achaval-tomas/SistemasDeTiempoReal/Core/Src/main.c

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
/* Includes ------------------------------------------------------------------*/
#include "main.h"
#include "i2c.h"
#include "icache.h"
#include "tim.h"
#include "gpio.h"

/* USER CODE BEGIN Includes */
#include "main_app.h"


void SystemClock_Config(void);
static void MPU_Config(void);
void MX_FREERTOS_Init(void);

/**
  * @brief  The application entry point.
  * @retval int
  */
int main(void)
{
  // Inicializar sistema
  MPU_Config();
  HAL_Init();
  SystemClock_Config();
  MX_ICACHE_Init();

  // Inicializar periféricos
  MX_GPIO_Init();
  MX_I2C1_Init();
  MX_I2C2_Init();
  MX_TIM2_Init();
  MX_TIM3_Init();

  // Lanzar el variómetro
  start_variometer();

  // Nunca se debería alcanzar este punto
  while (1){}
}

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
 /* MPU Configuration */

void MPU_Config(void)
{
  MPU_Region_InitTypeDef MPU_InitStruct = {0};
  MPU_Attributes_InitTypeDef MPU_AttributesInit = {0};

  /* Disables the MPU */
  HAL_MPU_Disable();

  /** Initializes and configures the Region 0 and the memory to be protected
  */
  MPU_InitStruct.Enable = MPU_REGION_ENABLE;
  MPU_InitStruct.Number = MPU_REGION_NUMBER0;
  MPU_InitStruct.BaseAddress = 0x08FFF000;
  MPU_InitStruct.LimitAddress = 0x08FFFFFF;
  MPU_InitStruct.AttributesIndex = MPU_ATTRIBUTES_NUMBER0;
  MPU_InitStruct.AccessPermission = MPU_REGION_ALL_RO;
  MPU_InitStruct.DisableExec = MPU_INSTRUCTION_ACCESS_DISABLE;
  MPU_InitStruct.IsShareable = MPU_ACCESS_NOT_SHAREABLE;

  HAL_MPU_ConfigRegion(&MPU_InitStruct);

  /** Initializes and configures the Attribute 0 and the memory to be protected
  */
  MPU_AttributesInit.Number = MPU_ATTRIBUTES_NUMBER0;
  MPU_AttributesInit.Attributes = INNER_OUTER(MPU_NOT_CACHEABLE);

  HAL_MPU_ConfigMemoryAttributes(&MPU_AttributesInit);
  /* Enables the MPU */
  HAL_MPU_Enable(MPU_PRIVILEGED_DEFAULT);

}

/**
  * @brief  Period elapsed callback in non blocking mode
  * @note   This function is called  when TIM6 interrupt took place, inside
  * HAL_TIM_IRQHandler(). It makes a direct call to HAL_IncTick() to increment
  * a global variable "uwTick" used as application time base.
  * @param  htim : TIM handle
  * @retval None
  */
void HAL_TIM_PeriodElapsedCallback(TIM_HandleTypeDef *htim)
{
  if (htim->Instance == TIM6)
  {
    HAL_IncTick();
  }
}

/**
  * @brief  This function is executed in case of error occurrence.
  * @retval None
  */
#include "lcd.h"
void Error_Handler(void)
{
  // Por ahora, los errores de hardware se muestran en la LCD
  // y luego se reincializa el sistema completo.
  lcd_init_emergency();
  lcd_printf_at(0, 0, "ERROR DE HARDWARE   ");
  lcd_printf_at(1, 0, "Sistema detenido    ");
  lcd_printf_at(2, 0, "Reintente encender  ");
  lcd_printf_at(3, 0, "el sistema en 5s... ");

  HAL_Delay(5000);

  // Reiniciar el sistema
  NVIC_SystemReset();
}

#ifdef USE_FULL_ASSERT
/**
  * @brief  Reports the name of the source file and the source line number
  *         where the assert_param error has occurred.
  * @param  file: pointer to the source file name
  * @param  line: assert_param error line source number
  * @retval None
  */
void assert_failed(uint8_t *file, uint32_t line)
{
  /* USER CODE BEGIN 6 */
  /* User can add his own implementation to report the file name and line number,
     ex: printf("Wrong parameters value: file %s on line %d\r\n", file, line) */
  /* USER CODE END 6 */
}
#endif /* USE_FULL_ASSERT */
