achaval-tomas/SistemasDeTiempoReal/Proyecto_FreeRtos.ioc

Mcu.UserName=STM32H533RETx
PA0.Signal=S_TIM2_CH1
PA13(JTMS/SWDIO).GPIO_Label=SWDIO
PA13(JTMS/SWDIO).Signal=DEBUG_JTMS-SWDIO
PA14(JTCK/SWCLK).GPIO_Label=SWCLK
PA14(JTCK/SWCLK).Signal=DEBUG_JTCK-SWCLK
PA15(JTDI).GPIO_Label=JTDI
PA15(JTDI).Signal=DEBUG_JTDI
PA2.Signal=USART2_TX
PA3.Signal=USART2_RX
PA6.Signal=S_TIM3_CH1
PA7.Signal=S_TIM3_CH2
PB10.Signal=I2C2_SCL
PB12.Signal=I2C2_SDA
PB3(JTDO/TRACESWO).GPIO_Label=SWO
PB3(JTDO/TRACESWO).Signal=DEBUG_JTDO-SWO
PB6.Signal=I2C1_SCL
PB7.Signal=I2C1_SDA
PC9.Signal=GPXTI9
