achaval-tomas/SistemasDeTiempoReal/Variometer/Src/task_sensor.c

#include "my_tasks.h"
#include "bmp280.h"
#include "portmacrocommon.h"
#include "projdefs.h"

// Estado actual y datos del filtro de Kalman
typedef struct {
    float pressure;     // presión en Pa
    float dp_dt;        // derivada de la presión en Pa/s
    float P[2][2];      // Matriz de covarianza de error
    float Q[2];         // Ruido de proceso (ajustable)
    float R;            // Ruido de medición (ajustable)
} sensorState_td;

sensorState_td sState = {
    .pressure = 0.0f, // DEBE SER INICIALIZADO CON UN VALOR DE PRESIÓN
    .dp_dt = 0.0f,
    .P =
    {
    {1.0f, 0.0f},
    {0.0f, 1.0f}
    },
    .Q =
    {
        0.001f,  // "Varianza" de la presión por paso
        0.01f    // "Varianza" de la derivada de la presión por paso
    },
    .R = 1.69f  // Sensor noise variance (RMS^2 según bosch)
};

static const float sensitivity_map[10] = {
    0.001f, 0.002f, 0.005f, 0.012f, 0.025f, 
    0.050f, 0.100f, 0.200f, 0.300f, 0.400f
};

float get_real_sensitivity(uint8_t user_level) {
    if (user_level < 1) user_level = 1;
    if (user_level > 10) user_level = 10;
    
    return sensitivity_map[user_level - 1];
}

// Inicializa los parámetros del filtro con un promedio de 30 lecturas del sensor.
void initialize_kalman(){
    bmp280_td bmp280 = {0};
    float pressSum = 0.0f;

    for (uint8_t i = 0; i < 30; ++i){
        bmp280_read_data(&bmp280);
        pressSum += bmp280.pressure_Pa;
        vTaskDelay(pdMS_TO_TICKS(100));
    }
    
    sState.pressure = pressSum / 30;
    sState.dp_dt = 0.0f;
    
    // Aplicar la sensibilidad definida por el usuario
    sState.Q[1] = get_real_sensitivity(varioConfig.sensitivity);
}

void apply_kalman_filter(float new_pressure) {
    static const float dt_s = (float)SENSOR_DT_MS / 1000.0f;

    // Predicción de la próxima presión
    sState.pressure = sState.pressure + (sState.dp_dt * dt_s);
    // Asumimos que dp_dt es constante durante dt_s

    // P = F*P*F' + Q
    float P00 = sState.P[0][0] + dt_s * (sState.P[1][0] + sState.P[0][1] + dt_s * sState.P[1][1]) + sState.Q[0];
    float P01 = sState.P[0][1] + dt_s * sState.P[1][1];
    float P10 = sState.P[1][0] + dt_s * sState.P[1][1];
    float P11 = sState.P[1][1] + sState.Q[1];

    // "Ganancia de Kalman"
    float S = P00 + sState.R;
    float K0 = P00 / S;
    float K1 = P10 / S;

    // Corrección del estado (x = x + K*y)
    float y = new_pressure - sState.pressure;
    sState.pressure += K0 * y;
    sState.dp_dt += K1 * y;

    // Corrección de covarianza (P = (I - KH)*P)
    sState.P[0][0] = (1.0f - K0) * P00;
    sState.P[0][1] = (1.0f - K0) * P01;
    sState.P[1][0] = P10 - (K1 * P00);
    sState.P[1][1] = P11 - (K1 * P01);
}

// Obtiene y filtra datos del sensor BMP280 para enviarlos a las tareas de buzzer y display
void BMP280Task(void *pvParameters) {
    float climb_rate = 0.0f;
    bmp280_td bmp280 = {0};
    buzzerQueueData_td buzzMsg = {0};
    displayQueueData_td dispMsg = {0};
    TickType_t lastTick;
    const TickType_t sensorDelayTicks = pdMS_TO_TICKS(SENSOR_DT_MS);
    
    // Inicializar el sensor con los parámetros deseados
    bmp280_init((bmp280_settings_td){
      .config = BMP_STANDBY_0_5ms | BMP_FILTER_OFF,
      .ctrl_meas = BMP_T_OSRS_1 | BMP_P_OSRS_16 | BMP_MODE_NORMAL
    });

    // Poner el sensor en modo sleep para ahorrar energía hasta que sea necesario
    bmp280_sleep();

sensor_off:
    // Esperar notificación de inicio de vuelo para despertar el sensor
    ulTaskNotifyTake(pdFALSE, portMAX_DELAY);
    bmp280_resume();
    
    // Notificar a la tarea del buzzer para que inicie
    buzzMsg.type = BUZZ_STARTUP;
    xQueueOverwrite(buzzerQueue, &buzzMsg);
    
    // Notificar al display que se inició un vuelo
    dispMsg.type = DISPLAY_START_FLIGHT;
    xQueueOverwrite(displayQueue, &dispMsg);

    // Obtener un primer valor de presión estabilizado
    // e inicializar los parámetros del filtro de Kalman
    initialize_kalman();

    lastTick = xTaskGetTickCount();
    
    // De aquí en adelante, los mensajes tienen siempre el mismo tipo hasta el shutdown
    buzzMsg.type = BUZZ_VARIO;
    dispMsg.type = DISPLAY_UPDATE_VARIO;
    
    while (1) {
        if (ulTaskNotifyTake(pdFALSE, 0) != 0) {
            // FIN DE VUELO: Notificar al buzzer y dejar de hacer mediciones
            buzzMsg.type = BUZZ_SHUTDOWN;
            xQueueOverwrite(buzzerQueue, &buzzMsg);
            bmp280_sleep();
            goto sensor_off;
        }

        bmp280_read_data(&bmp280);
        apply_kalman_filter(bmp280.pressure_Pa);
        
        // Pascales por segundo a metros por segundo, ajustado por la presión actual.
        climb_rate = (sState.pressure > 0.0f) ? ((-sState.dp_dt * 8434.42f) / sState.pressure) : 0.0f;
        
        // Encolar los datos nuevos a la tarea del buzzer
        buzzMsg.vario_climb_rate = climb_rate;
        xQueueOverwrite(buzzerQueue, &buzzMsg);

        // Encolar los datos nuevos a la tarea del display
        dispMsg.varioData = (genericSensorData_td){
            .pressure_Pa = sState.pressure,
            .temperature_C = bmp280.temperature_C,
            .climb_rate_mps = climb_rate
        };
        xQueueOverwrite(displayQueue, &dispMsg);

        vTaskDelayUntil(&lastTick, sensorDelayTicks);
    }
}
