achaval-tomas/SistemasDeTiempoReal/Variometer/Drivers/lcd/lcd.c

#include "lcd.h"
#include "stm32h5xx_hal.h"
#include "i2c.h"
#include <stdint.h>
#include <stdio.h>
#include <stdarg.h>
#include <string.h>

/* LCD Hardware Mapping */
#define SLAVE_ADDRESS_LCD 0x4E
#define PIN_RS            (1 << 0)
#define PIN_RW            (1 << 1)
#define PIN_EN            (1 << 2)
#define BACKLIGHT         (1 << 3)

/* HD44780 Command Set */
typedef enum {
    LCD_CMD_CLEAR_DISPLAY   = 0x01,
    LCD_CMD_RETURN_HOME     = 0x02,
    LCD_CMD_ENTRY_MODE_SET  = 0x06,
    LCD_CMD_DISPLAY_CONTROL = 0x08,
    LCD_CMD_CURSOR_SHIFT    = 0x10,
    LCD_CMD_FUNCTION_SET    = 0x20,
    LCD_CMD_SET_CGRAM_ADDR  = 0x40,
    LCD_CMD_SET_DDRAM_ADDR  = 0x80
} lcd_commands_t;

/* Display Control Flags */
#define LCD_DISPLAY_ON      0x04
#define LCD_DISPLAY_OFF     0x00
#define LCD_CURSOR_ON       0x02
#define LCD_CURSOR_OFF      0x00
#define LCD_BLINK_ON        0x01
#define LCD_BLINK_OFF       0x00
// 0x28 -> 4-bit mode, 2 lines (even for 4-line displays), 5x8 font
#define LCD_4BIT_MODE       0x28 

// Variables de estado internas
static uint8_t lcd_backlight_val = 0; // Initialized OFF
static uint8_t lcd_initialized = 0;
static char lines[DISPLAY_LINE_COUNT][DISPLAY_LINE_WIDTH + 1];

void lcd_send_internal(uint8_t data, uint8_t flags) {
    uint8_t up = data & 0xF0;
    uint8_t lo = (data << 4) & 0xF0;
    uint8_t data_t[4]; 
    
    data_t[0] = up | flags | lcd_backlight_val | PIN_EN;
    data_t[1] = up | flags | lcd_backlight_val;
    data_t[2] = lo | flags | lcd_backlight_val | PIN_EN;
    data_t[3] = lo | flags | lcd_backlight_val;

    HAL_I2C_Master_Transmit(&hi2c2, SLAVE_ADDRESS_LCD, data_t, 4, 100);
}

void lcd_send_cmd(uint8_t cmd) {
    lcd_send_internal(cmd, 0);
}

void lcd_send_data(uint8_t data) {
    lcd_send_internal(data, PIN_RS);
}

// Saves a custom character to 1 of 8 CGRAM slots (locations 8-15)
void lcd_create_custom_char(uint8_t location, const uint8_t charmap[]) {
    // Convert 8-15 to 0-7 for proper addressing
    uint8_t hardware_slot = (uint8_t)location & 0x07; 
    
    lcd_send_cmd(LCD_CMD_SET_CGRAM_ADDR | (hardware_slot << 3));
    for (int i = 0; i < 8; i++) {
        lcd_send_data(charmap[i]);
    }
    lcd_send_cmd(LCD_CMD_SET_DDRAM_ADDR); 
}

void lcd_load_custom_characters() {
    const uint8_t up_arrow[8]   = {0x04, 0x0E, 0x15, 0x04, 0x04, 0x04, 0x04, 0x00};
    const uint8_t down_arrow[8] = {0x04, 0x04, 0x04, 0x04, 0x15, 0x0E, 0x04, 0x00};
    
    // linea solida que apunta la opción seleccionada del menú
    const uint8_t right_pointer[8] = {
        0x08, // 0 1 0 0 0
        0x0C, // 0 1 1 0 0
        0x0E, // 0 1 1 1 0
        0x0F, // 0 1 1 1 1
        0x0E, // 0 1 1 1 0
        0x0C, // 0 1 1 0 0
        0x08, // 0 1 0 0 0
        0x00  // 0 0 0 0 0
    };

    const uint8_t no_climb[8] = {
        0b00000,
        0b00000,
        0b00000,
        0b00000,
        0b00000,
        0b11111,
        0b00000,
        0b00000
    };

    const uint8_t small_climb[8] = {
        0b00000,
        0b00000,
        0b00000,
        0b01110,
        0b11111,
        0b11111,
        0b00000,
        0b00000
    };

    const uint8_t big_climb[8] = {
        0b00000,
        0b00000,
        0b01110,
        0b11111,
        0b11111,
        0b11111,
        0b00000,
        0b00000
    };

    const uint8_t max_climb[8] = {
        0b01110,
        0b11111,
        0b11111,
        0b11111,
        0b11111,
        0b11111,
        0b00000,
        0b00000
    };

    const uint8_t sink[8] = {
        0b00000,
        0b00000,
        0b00000,
        0b00000,
        0b00000,
        0b11111,
        0b11111,
        0b01110
    };
    
    lcd_create_custom_char(CHAR_UP_ARROW, up_arrow);
    lcd_create_custom_char(CHAR_DOWN_ARROW, down_arrow);
    lcd_create_custom_char(CHAR_RIGHT_POINTER, right_pointer);
    lcd_create_custom_char(CHAR_NO_CLIMB, no_climb);
    lcd_create_custom_char(CHAR_SMALL_CLIMB, small_climb);
    lcd_create_custom_char(CHAR_BIG_CLIMB, big_climb);
    lcd_create_custom_char(CHAR_MAX_CLIMB, max_climb);
    lcd_create_custom_char(CHAR_SINK, sink);
}

void lcd_init(void) {
    HAL_Delay(50);

    uint8_t cmd = 0x30 | lcd_backlight_val;
    uint8_t data_t[2] = {cmd | PIN_EN, cmd}; 
    
    for(int i = 0; i < 3; i++) {
        HAL_I2C_Master_Transmit(&hi2c2, SLAVE_ADDRESS_LCD, data_t, 2, 100);
        HAL_Delay(i == 0 ? 5 : 1);
    }

    uint8_t data_4bit[2] = {(0x20 | lcd_backlight_val) | PIN_EN, (0x20 | lcd_backlight_val)};
    HAL_I2C_Master_Transmit(&hi2c2, SLAVE_ADDRESS_LCD, data_4bit, 2, 100);
    HAL_Delay(10);

    lcd_send_cmd(LCD_4BIT_MODE);
    lcd_send_cmd(LCD_CMD_DISPLAY_CONTROL | LCD_DISPLAY_OFF);
    
    lcd_clear();

    lcd_send_cmd(LCD_CMD_ENTRY_MODE_SET);

    lcd_load_custom_characters();

    lcd_initialized = 1;
}

void lcd_init_emergency(void) {
    if (lcd_initialized){
        lcd_send_cmd(LCD_CMD_DISPLAY_CONTROL | LCD_DISPLAY_ON);
        return;
    }

    lcd_init();
    lcd_send_cmd(LCD_CMD_DISPLAY_CONTROL | LCD_DISPLAY_ON);
}

void lcd_send_string(char *str) {
    if (!str) return;

    for (size_t i = 0; i < DISPLAY_LINE_WIDTH && str[i] != '\0'; i++) {
        lcd_send_data((uint8_t)str[i]);
    }
}

void lcd_put_cur(uint8_t row, uint8_t col) {
    uint8_t pos;
    
    // Calculate DDRAM address based on row mapping for 20x4
    switch (row) {
        case 0:
            pos = 0x00 + col;
            break;
        case 1:
            pos = 0x40 + col;
            break;
        case 2:
            pos = 0x14 + col;
            break;
        case 3:
            pos = 0x54 + col;
            break;
        default:
            pos = 0x00 + col;
            break;
    }
    
    lcd_send_cmd(LCD_CMD_SET_DDRAM_ADDR | pos);
}

void lcd_clear(void) {
    lcd_send_cmd(LCD_CMD_CLEAR_DISPLAY);
    HAL_Delay(2);

    for (uint8_t row = 0; row < DISPLAY_LINE_COUNT; row++) {
        memset(lines[row], ' ', DISPLAY_LINE_WIDTH);
        lines[row][DISPLAY_LINE_WIDTH] = '\0';
    }
}


/*
 *  Imprime un string formateado en la posición (row, col) de la pantalla LCD.
 *  Solo actualiza los caracteres que han cambiado para minimizar el tráfico I2C.
 */
void lcd_printf_at(uint8_t row, uint8_t col, const char *fmt, ...) {
    if (row >= DISPLAY_LINE_COUNT || col >= DISPLAY_LINE_WIDTH)
        return;

    char buffer[DISPLAY_LINE_WIDTH + 1];
    va_list args;
    va_start(args, fmt);
    vsnprintf(buffer, sizeof(buffer), fmt, args);
    va_end(args);

    size_t len = strlen(buffer);

    if (len > DISPLAY_LINE_WIDTH - col)
        len = DISPLAY_LINE_WIDTH - col;

    for (size_t i = 0; i < len; ){
        // Saltear caracteres que ya están en la pantalla
        while (i < len && buffer[i] == lines[row][col + i]) {
            i++;
        }
        if (i == len)
            break;

        // Mover el cursor a la posición correcta y escribir los caracteres
        // hasta que se encuentre otra coincidencia o se alcance el final de la línea
        lcd_put_cur(row, col + i);
        do {
            lcd_send_data((uint8_t)buffer[i]);
            lines[row][col + i] = buffer[i];
            i++;
        } while (i < len && buffer[i] != lines[row][col + i]);
    }
}

void lcd_backlight(uint8_t state) {
    lcd_backlight_val = state ? BACKLIGHT : 0;
    lcd_send_cmd(LCD_CMD_DISPLAY_CONTROL | LCD_DISPLAY_ON);
}

void lcd_off(void) {
    lcd_backlight_val = 0;
    lcd_send_cmd(LCD_CMD_DISPLAY_CONTROL | LCD_DISPLAY_OFF);
}

void lcd_on(void) {
    lcd_backlight_val = BACKLIGHT;
    lcd_send_cmd(LCD_CMD_DISPLAY_CONTROL | LCD_DISPLAY_ON);
}

void lcd_cursor(uint8_t mode) {
    switch(mode) {
        case 0: lcd_send_cmd(LCD_CMD_DISPLAY_CONTROL | LCD_DISPLAY_ON | LCD_CURSOR_OFF); break;
        case 1: lcd_send_cmd(LCD_CMD_DISPLAY_CONTROL | LCD_DISPLAY_ON | LCD_CURSOR_ON); break;
        case 2: lcd_send_cmd(LCD_CMD_DISPLAY_CONTROL | LCD_DISPLAY_ON | LCD_CURSOR_ON | LCD_BLINK_ON); break;
    }
}
