achaval-tomas/SistemasDeTiempoReal/Variometer/Src/task_buzzer.c

#include "my_tasks.h"
#include "buzzer.h"
#include "vario_config.h"
#include <stdint.h>

void get_buzz_params(float climb_rate, uint32_t *frequencyHZ, uint32_t *durationMS, uint32_t *silenceMS){
    if (frequencyHZ == NULL || durationMS == NULL || silenceMS == NULL) return;

    // Valores en 0, no serán modificados si no se cumplen las condiciones de lift/sink
    uint32_t freq = 0, duration = 0, silence = 0;
    float delta_rate = 0.0f;

    // Calcular los parámetros del "beep" según el climb_rate y los umbrales configurados
    if (climb_rate >= varioConfig.lift_threshold) {
        delta_rate = climb_rate - varioConfig.lift_threshold; // delta_rate será positivo
        freq = (uint32_t)(varioConfig.lift_hz_base + (delta_rate * varioConfig.lift_hz_scale));

        duration = 400 - (uint32_t)(delta_rate * 100);
        duration = (duration < 50) ? 50 : duration;

        silence = 50 - (uint32_t)(delta_rate * 10);
        silence = (silence < 10) ? 10 : silence;

    } else if (climb_rate <= varioConfig.sink_threshold) {
        delta_rate = climb_rate - varioConfig.sink_threshold; // delta_rate será negativo
        freq = (uint32_t)(varioConfig.sink_hz_base + (delta_rate * varioConfig.sink_hz_scale));

        if (freq < (uint32_t)varioConfig.sink_hz_min) {
            freq = (uint32_t)varioConfig.sink_hz_min;
        }

        duration = 500;
        silence = 100;
    }

    *frequencyHZ = freq;
    *durationMS = duration;
    *silenceMS = silence;
}

void Buzzer(uint32_t frequencyHZ, uint32_t durationMS){
  if (frequencyHZ == 0 || durationMS == 0) return;

  // Emitir el sonido con la frecuencia y duración especificadas, usando el volumen configurado
  buzz_start(frequencyHZ, (uint8_t)varioConfig.volume);
  vTaskDelay(pdMS_TO_TICKS(durationMS));
  buzz_stop();
}

void PlayStartupTune(){
  uint32_t frequencyHZ, durationMS;

  for (int i = 0; i < 3; i++){
    frequencyHZ = 500 + i*200;
    durationMS = 250 - i*50;

    Buzzer(frequencyHZ, durationMS);
    if (i == 2) break;
    vTaskDelay(pdMS_TO_TICKS(20));
  }
}

void PlaySwitchOffTune(){
  uint32_t frequencyHZ, durationMS;

  for (int i = 0; i < 4; i++){
    frequencyHZ = 1000 - i*200;
    durationMS = 100 + i*10;

    Buzzer(frequencyHZ, durationMS);
    if (i == 3) break;
    vTaskDelay(pdMS_TO_TICKS(20));
  }
}

void BuzzerTask(void *pvParameters){
  // Inicia señal PWM sin volumen
  buzz_init();

  buzzerQueueData_td bqData;
  uint32_t frequencyHZ = 0, durationMS = 0, silenceMS = 0;

  while (1){
    xQueueReceive(buzzerQueue, (void *)&bqData, portMAX_DELAY);

    switch(bqData.type){
      case BUZZ_VARIO:

        get_buzz_params(bqData.vario_climb_rate, &frequencyHZ, &durationMS, &silenceMS);
        if (frequencyHZ != 0){
          Buzzer(frequencyHZ, durationMS);
          vTaskDelay(pdMS_TO_TICKS(silenceMS));
        }
        
        break;

      case BUZZ_NEW_VOLUME:
        // Beep para que el usuario sepa que el volumen cambió
        Buzzer((uint32_t)(varioConfig.lift_hz_base), 200);
        break;

      case BUZZ_STARTUP:
        PlayStartupTune();
        break;

      case BUZZ_SHUTDOWN:
        PlaySwitchOffTune();
        break;

      default:
        // ignorar
        break;
    }
  }
}
