achaval-tomas/SistemasDeTiempoReal/(commit log)

2026-04-10 Initial project with I2C+PWM setup in CUBEMX
2026-04-10 working bmp280 calibration, data reading and altitude estimation
2026-04-10 song plays when pressure changes (attempt1)
2026-04-10 use Pa instead of hPa for pressure
2026-04-10 Fix tim2, refactor songPlayer into initial implementation of Variometer
    [main.c]
2026-04-10 Add switch ON to variometer, Fix init function problems
    [main.c]
2026-04-12 Initial full variometer implementation
    TODO: Turn Buzzer into a task so it doesn't affect the Variometer delay management
    [main.c]
2026-04-12 Variometer can now be switched off with button press, using non-blocking task notifications
2026-04-15 add on/off prints
2026-04-15 improve debug climb print
2026-04-15 Enable float prints
2026-04-17 ADD i2c LCD support!
2026-04-17 moved lcd to i2c2
2026-04-17 Turn buzzer into its own task, communicate through queue
    [main.c]
2026-04-18 display temperature (some flickering)
2026-04-18 move frequency math to buzzer task, handle variometer with global variables
    [my_tasks.h, task_buzzer.c]
2026-04-18 reduce queue size and use xQueueOverwrite, reworked priority scheme
    [main.c]
2026-04-19 improve low-pass filters to be dt-responsive
2026-04-21 Refactor: Redefine task structure
    New simple sensor reading task
    Fixed rate variometer and sensor tasks
    Buzzer task now creates the "time-responsiveness"
    [main_app.c, my_tasks.h, task_buzzer.c, task_display.c, task_sensor.c]
2026-04-22 small tweaks to config and buzzer duration
    [Proyecto_FreeRtos.ioc, bmp280.c, main.c, main_app.c, my_tasks.h, task_buzzer.c]
2026-04-22 first attempt at Kalman Filter
2026-04-22 Updates to bmp280 and filter settings
2026-04-22 Refactor: move filtering logic to sensor task
2026-04-22 remove unnecessary buzzer logic from variometer task
    [task_buzzer.c]
2026-04-22 variometer now blocks on sensor queue only, each subtask handles its timing
2026-04-23 Refactor: relocate vario drivers
2026-04-24 use Task Notifications to start and stop the sensor task from variometer task
2026-04-30 user interface, switch to 20x4 displau
2026-05-01 update cubeMX for encoder
2026-05-01 Usar software timer para polling de baja importancia al encoder
2026-05-01 enable/disable encoder software timer
2026-05-09 improve encoder delta handling
2026-05-12 reduce sensor measurement frequency, improve resolution
2026-05-12 simplify encoder logic
2026-05-12 Create buzzer driver and simplify buzzer task
    [buzzer.c, buzzer.h, my_tasks.h, task_buzzer.c]
2026-05-12 reset instead of restart encoder on enable
    [encoder.c]
2026-05-13 slightly simplify encoder event queue handling
2026-05-13 Usar one-shot timer para long press en lugar de esperar release
2026-05-13 variable rename in encoder driver
2026-06-03 use one line for function calls in buzzer and display tasks
    [task_buzzer.c, task_display.c]
2026-06-03 improve display task print logic stop using temp variable for double-formatting and spacing, instead use trailing spaces and direct prints
2026-06-05 config timer for new buzzer module with 5v logic
2026-06-19 Reset timer instead of "start" to avoid incorrect long press detections
    [encoder.c]
2026-06-27 Simplify sensor messaging logic
2026-06-27 Make sensor sleep when not in flight mode
2026-06-27 fix small bug in flight mode initialization
    There was a problem when stopping flight mode while initializing, now solved by checking for shutdown at the start of each sensor loop
    [task_sensor.c]
2026-06-27 fix "break;" indentation in switch block
    [task_display.c]
2026-06-27 make encoder event struct assignments explicit
2026-06-28 Fix flight mode on-off bug
    It was possible to start it, stop it and re-start it while the task was still calibrating the sensor, but both notifications were consumed as a single shut-down notice causing a bug.
    [task_sensor.c]
2026-06-28 Clean up UI Task
    Also possibly fixed a bug of long-press being double-detected after coming off flight mode by using a do-while statement
    [task_ui.c]
2026-06-28 Clean up Buzzer Task
    [task_buzzer.c]
2026-06-28 Clean up Sensor Task
2026-06-29 reuse temperature variable for legibility
2026-06-29 fix display delay handling and clear flight history at each re-start
    [my_tasks.h, task_display.c]
2026-06-30 Make lcd prints safer
2026-07-01 Reescribir prioridades en términos de MAX_PRIORITY y darle prioridad máxima a los SW timers
2026-07-01 Reduce unnecessarily long wait time after switching display ON
2026-07-01 Fix sink delta rate buzzer logic
    [task_buzzer.c]
2026-07-01 Implement fatal error handler
    [lcd.c, lcd.h, main.c]
2026-07-01 Use fatal error handler to check every HAL read (except for display-related ones)
    [bmp280.c, bmp280.h, buzzer.c, buzzer.h, encoder.c, encoder.h, lcd.c, lcd.h]
2026-07-01 fix error handler.
    It is now intended to cover for all possible HAL errors after display initialization
    [lcd.c, lcd.h, main.c]
2026-07-01 add emergency lcd init for error handler
    [lcd.c, lcd.h, main.c]
2026-07-01 Improve altitude estimation formula
    Now it doesnt depend on external temperature
2026-07-01 Reset full system on fatal error
    [main.c]
2026-07-02 only print changed characters in lcd
2026-07-02 fix flicker in page number indicator
    [task_display.c]
2026-07-02 Possibly fix random display-off issue
    [lcd.c, task_display.c, task_ui.c]
2026-07-02 Definitely fix ghost long press issue
    It was a bounce problem after button release, generating another falling edge EXTI which launched the one-shot timer again.
    Now all button presses are debounced both ways (falling and rising) and the long-press timer checks that the button is still pressed
    [encoder.c, encoder.h]
2026-07-02 Invert order of checks in long press timer callback.
    This ensures that every time the semaphore is taken, an event is generated. Solves a possible race condition where button was released after token was taken by timer but before checking button state.
    [encoder.c]
2026-07-03 Translate some comments and add unreachable safety reset
    [main.c, main_app.c]
